FesixGermany/M3_80/documentation/pictures/soldering_jig.jpg

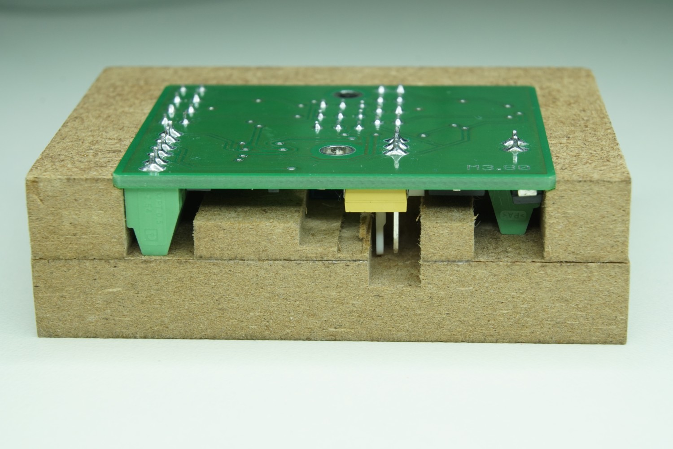
documentation/pictures/soldering_jig.jpg
