FesixGermany/M3_80/documentation/pictures/operation.jpg

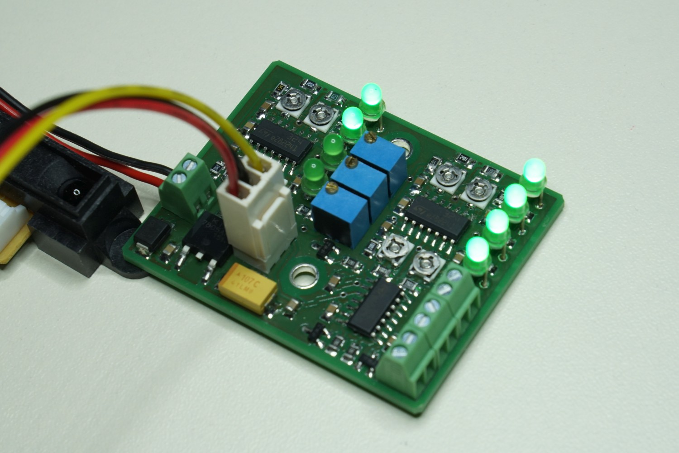
documentation/pictures/operation.jpg
