FesixGermany/M3_80/README.md

All files about the school project M3.80 we developed in a group of four in 2015.

See documentation/description_en.pdf or Beschreibung_DE.pdf for more info.
