FesixGermany/M3_80/documentation/voltage_diagrams.pdf

Tabelle1

Sensor 1 | Sensor 2
10 | 2,25 | 2,30 | 2,35
15 | 1,60 | 1,63 | 1,70
20 | 1,30 | 1,28 | 1,36
25 | 1,10 | 1,04 | 1,15
30 | 0,90 | 0,87 | 1,00
35 | 0,80 | 0,75 | 0,90
40 | 0,75 | 0,63 | 0,80
45 | 0,65 | 0,56 | 0,72
50 | 0,60 | 0,50 | 0,66
55 | 0,55 | 0,44 | 0,60
60 | 0,50 | 0,39 | 0,54
65 | 0,45 | 0,34 | 0,49
70 | 0,40 | 0,30 | 0,42

Measured voltages

Datasheet

Distance / cm | Value / V | Value / V | Value / V

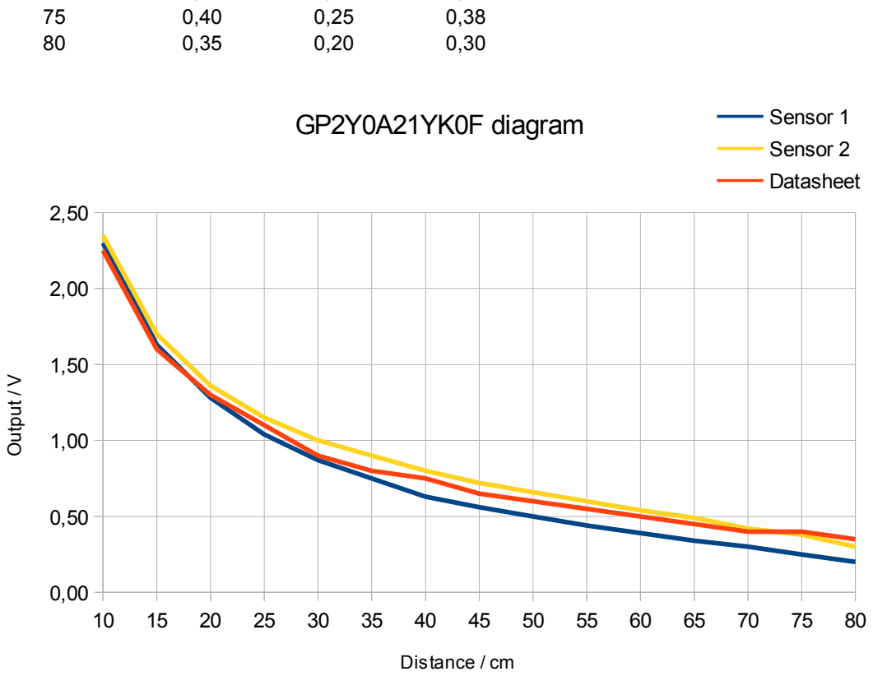
[picture p3: figure]
GP2Y0A21YK0F diagram; Sensor 1; Sensor 2 Datasheet; Distance / cm; Output / V
