FesixGermany/M3_80/documentation/pictures/cable_sensor.jpg

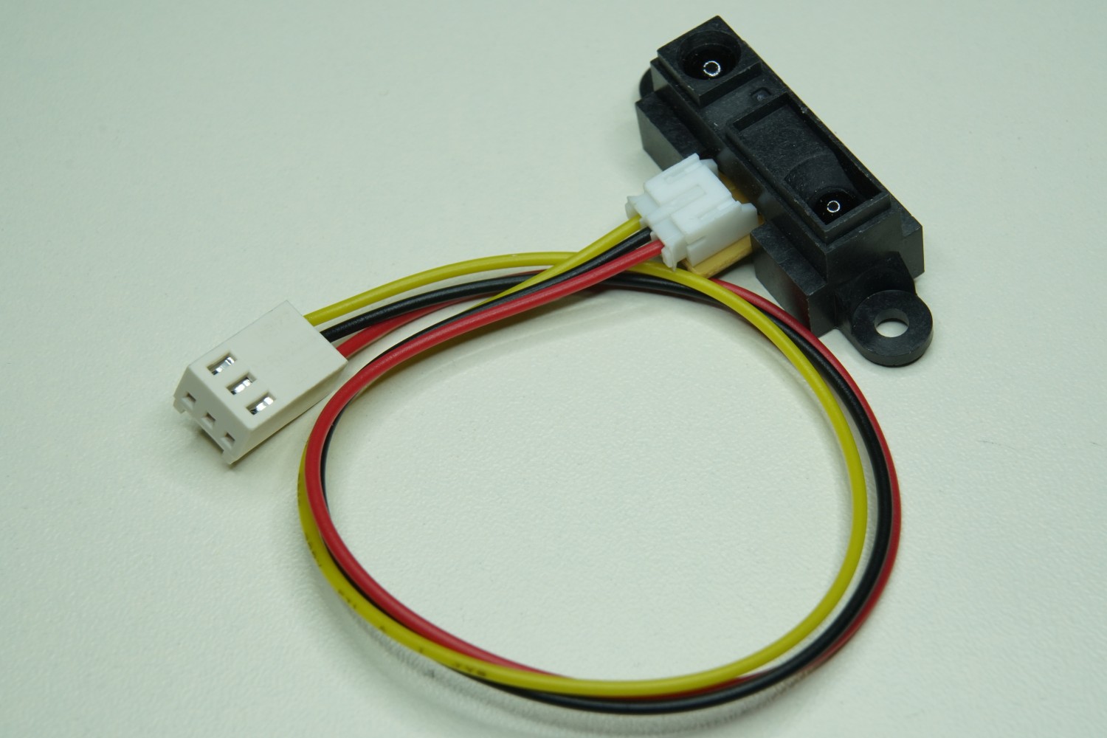
documentation/pictures/cable_sensor.jpg
