FesixGermany/M3_80/documentation/pictures/pcba.jpg

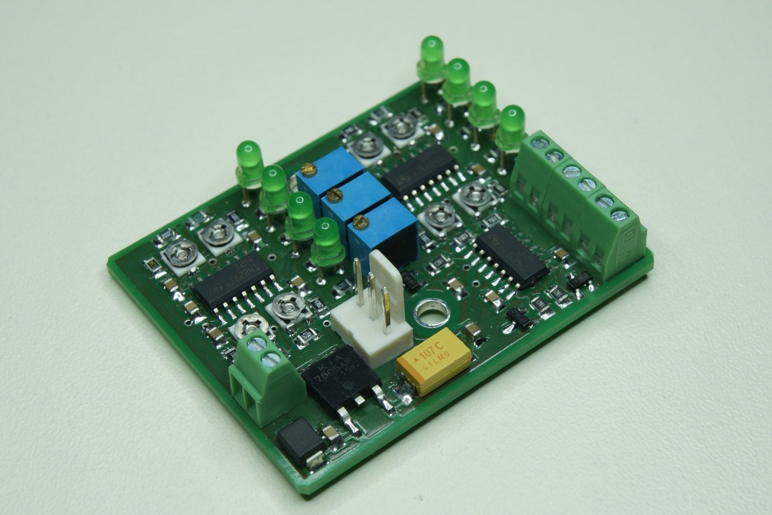
documentation/pictures/pcba.jpg
