FesixGermany/M3_80/documentation/pictures/pcba_top.jpg

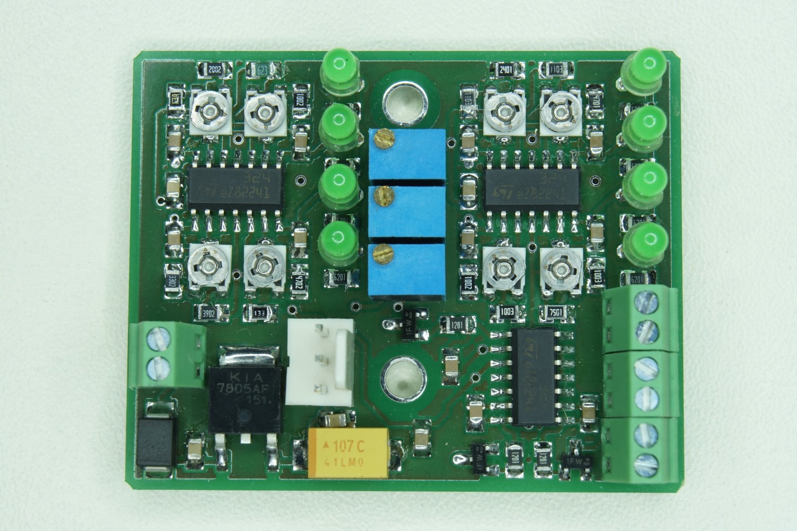
documentation/pictures/pcba_top.jpg
