FesixGermany/M3_80/documentation/pictures/prototype.jpg

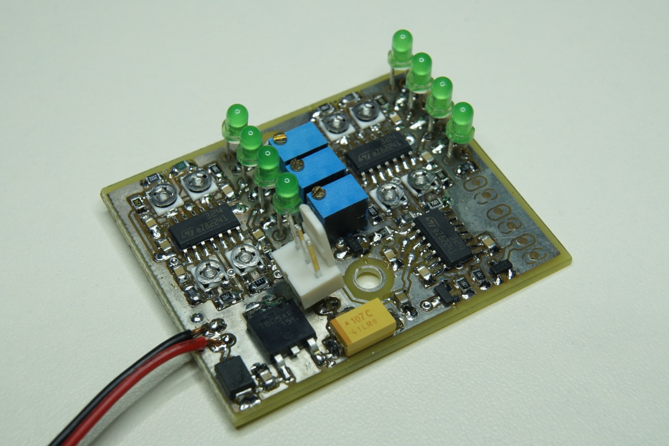
documentation/pictures/prototype.jpg
