FesixGermany/M3_80/soldering jig/soldering jig.stp

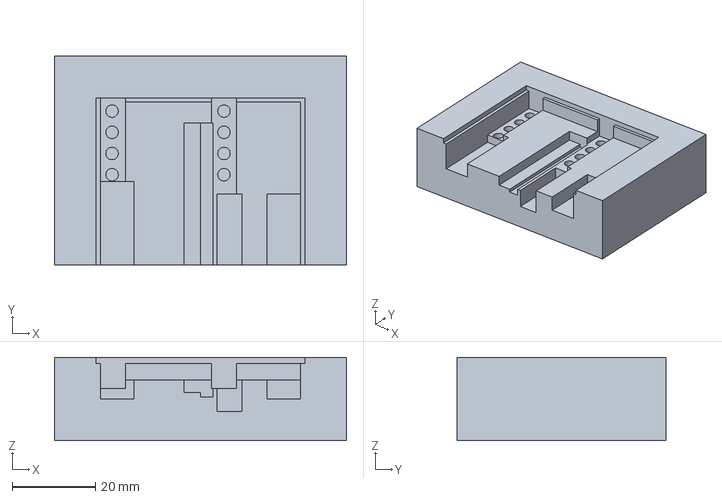
[picture p8: CAD file, 2019-12-20]
soldering jig/soldering jig.stp
70.0 x 50.0 x 20.0 mm
