FesixGermany/M3_80/documentation/M3_80_Dimensions.pdf

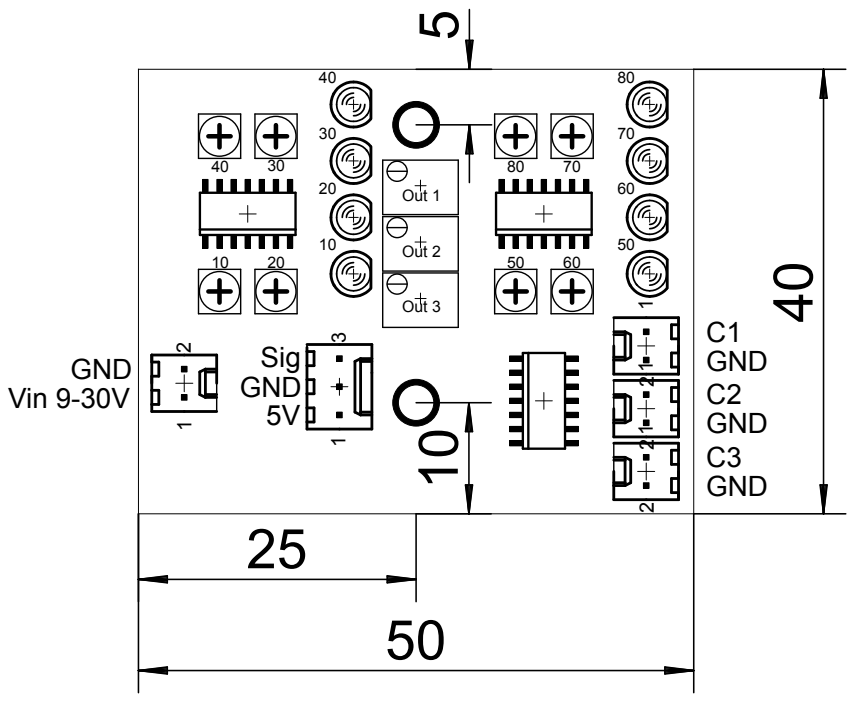
[picture p9: page 1]
C1 GND C2 GND C3 GND; GND Vin 9-30V; Sig GND 5V

Out 1

Out 2

Out 3
