FesixGermany/M3_80/documentation/M3_80_Schematic A4.pdf

A

A

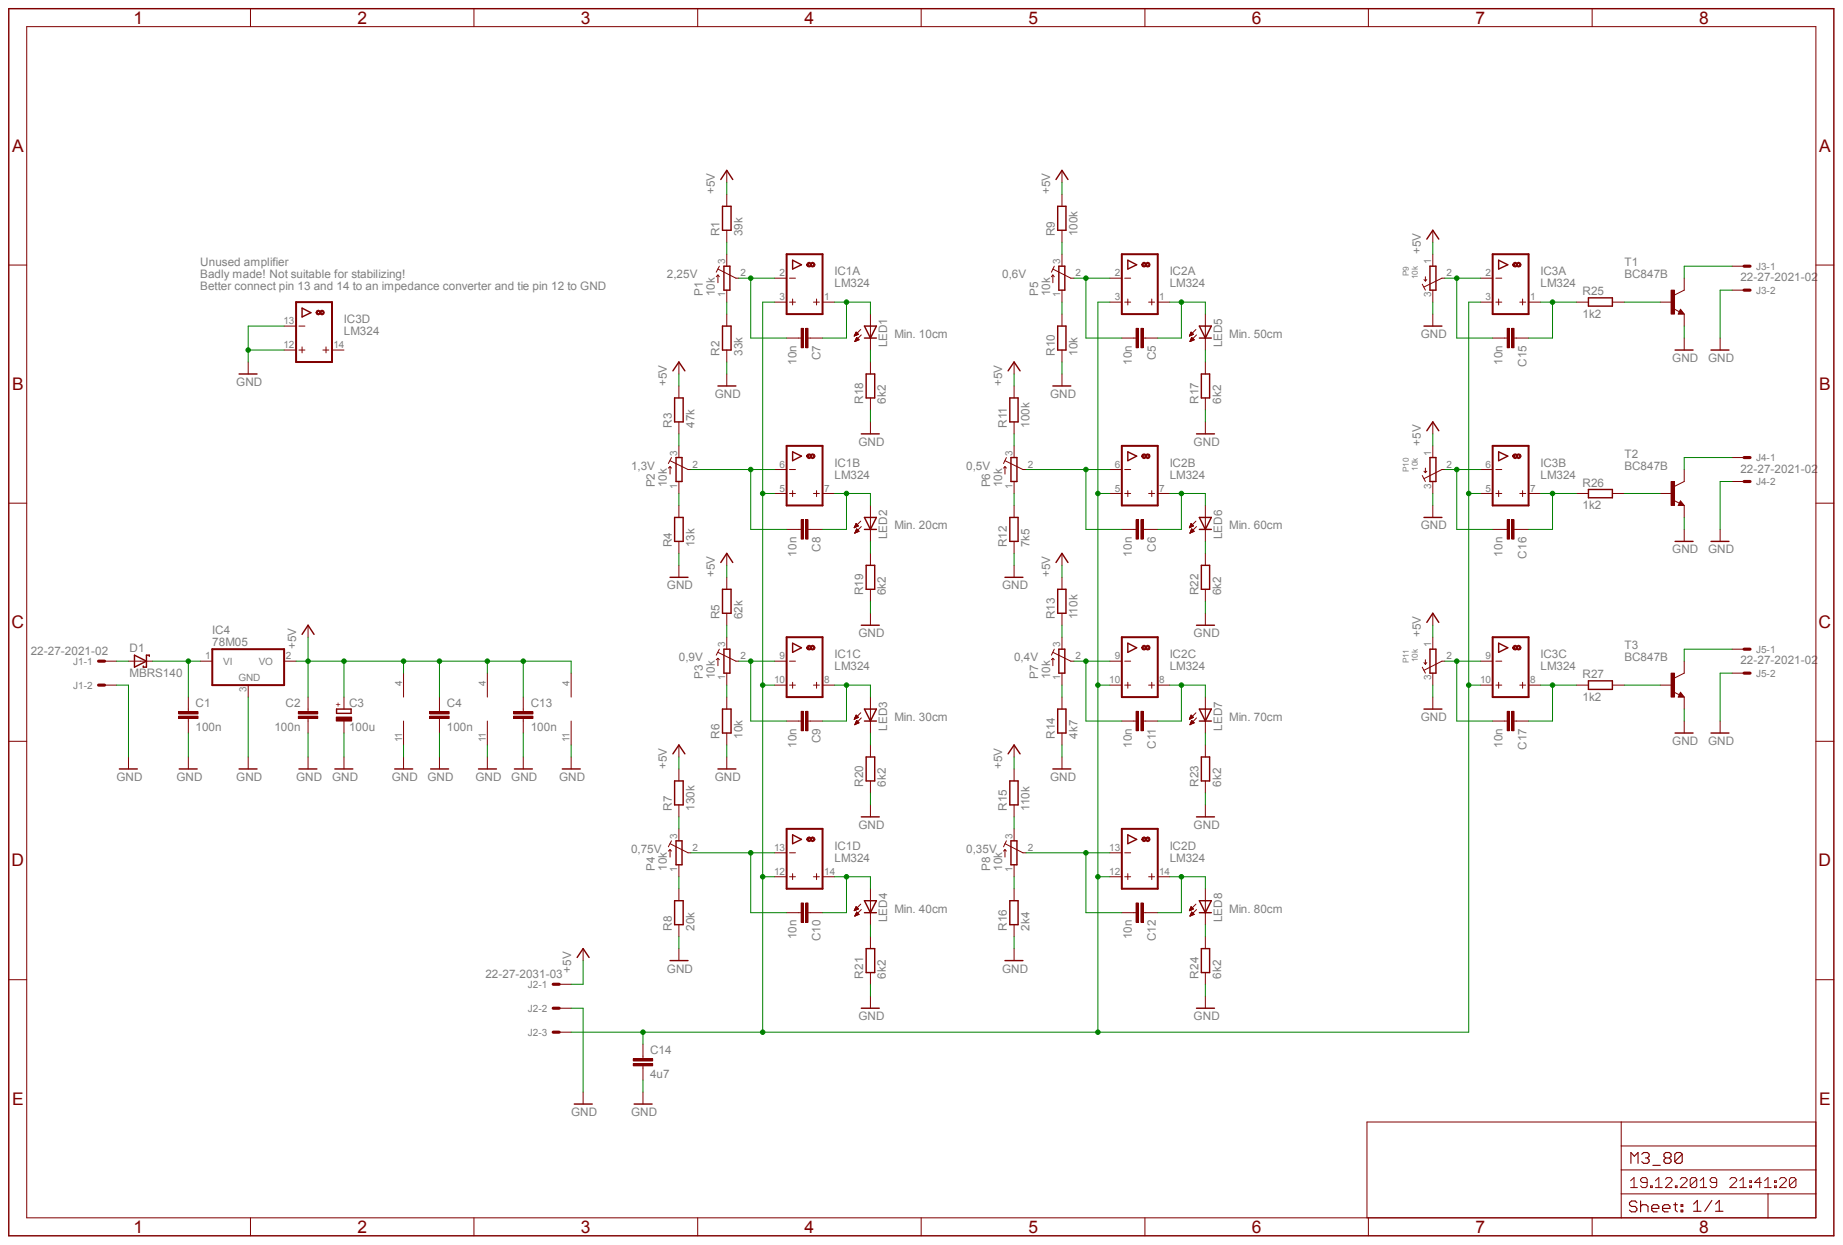
[picture p10: page 1]

Unused amplifier
Badly made! Not suitable for stabilizing!
