FesixGermany/M3_80/documentation/M3_80_Schematic_A3.pdf

A

A

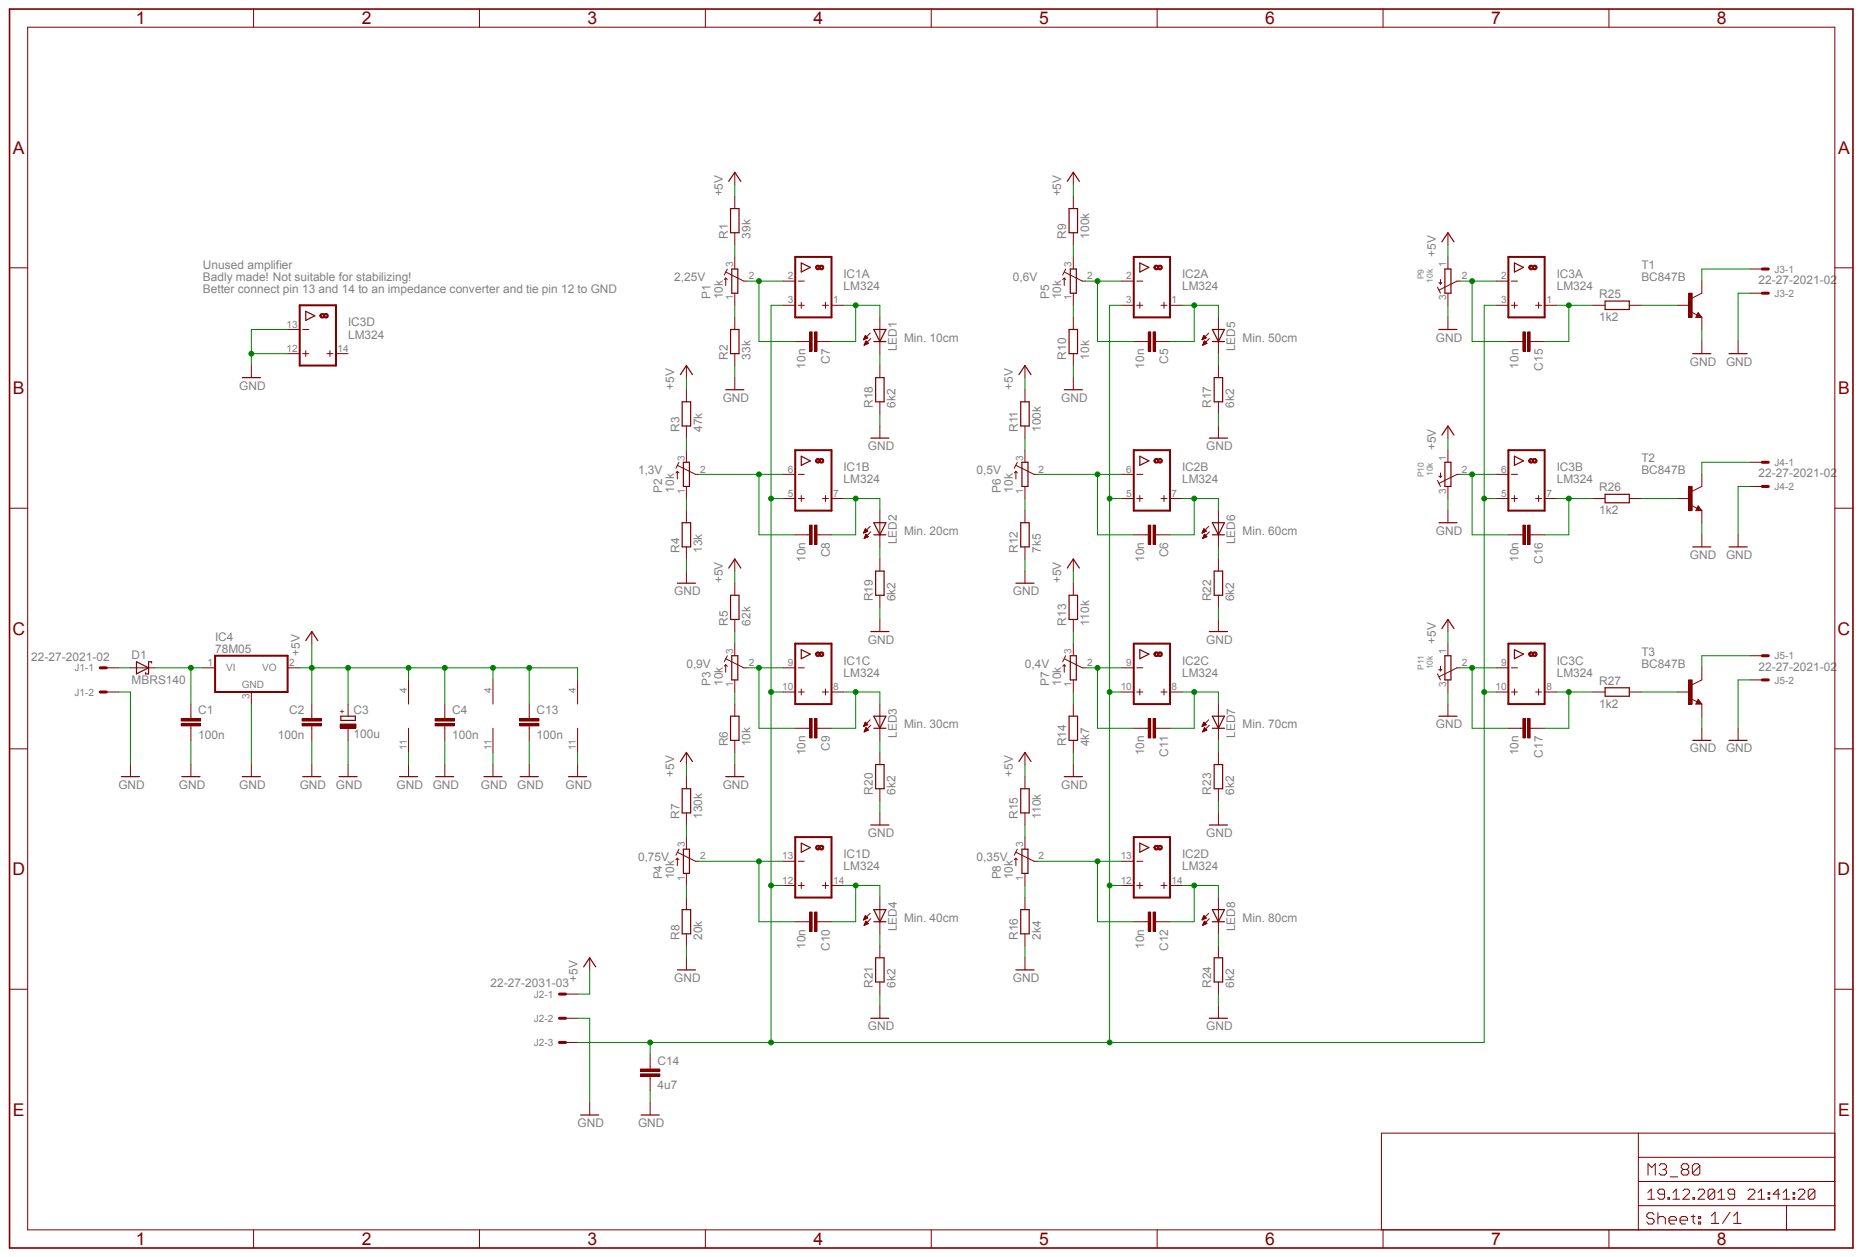
[picture p11: page 1]

Unused amplifier
Badly made! Not suitable for stabilizing!
