FesixGermany/M3_80/documentation/M3_80_Layout.pdf

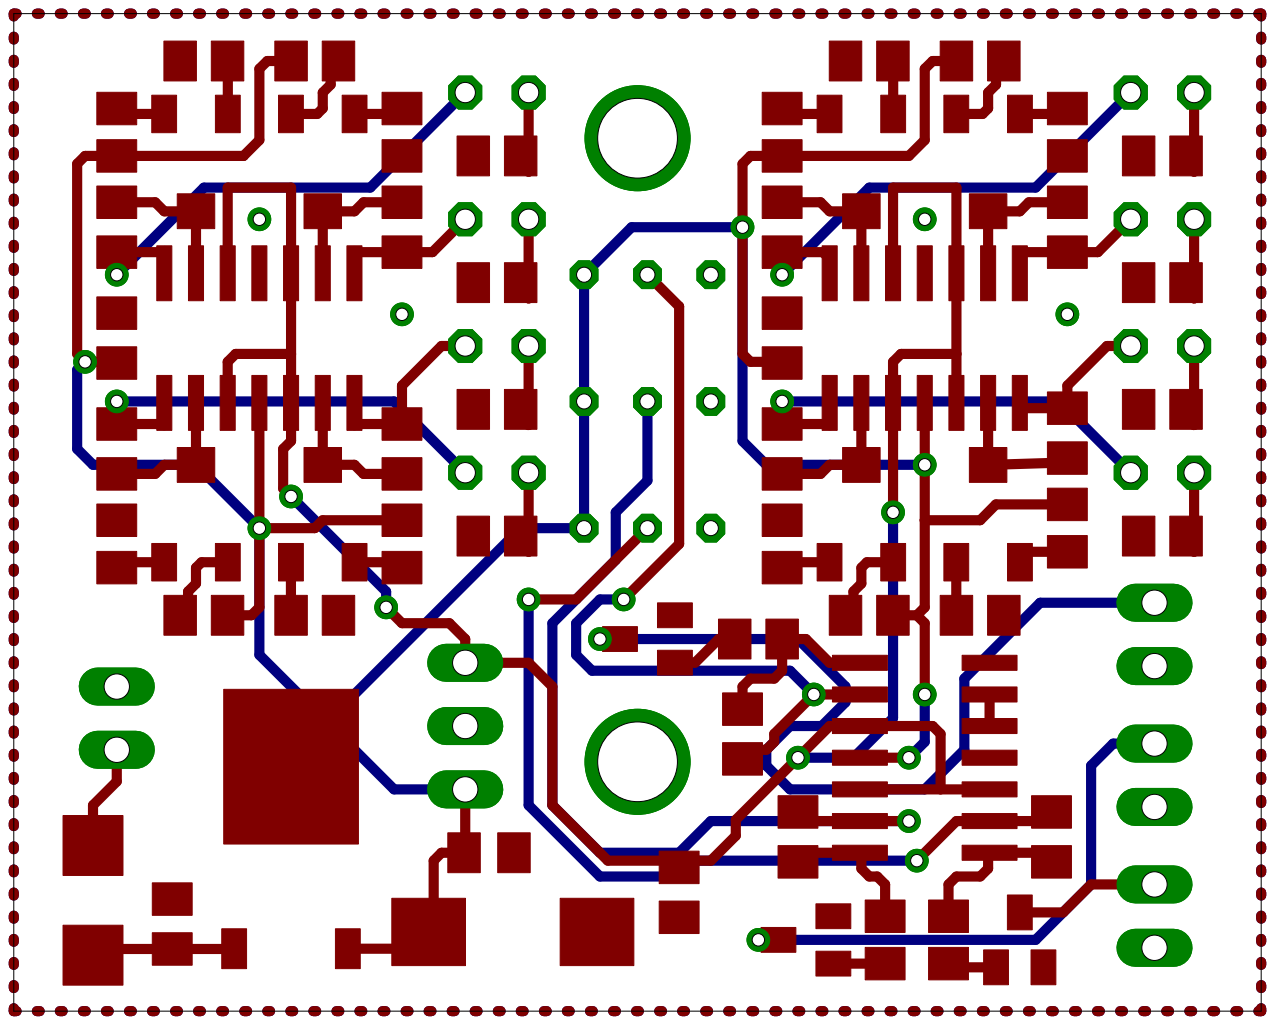
[picture p12: page 1]
