FesixGermany/M3_80/schematic and board files/M3_80.brd

## EAGLE design schematic and board files/M3_80.brd (2019-12-20)

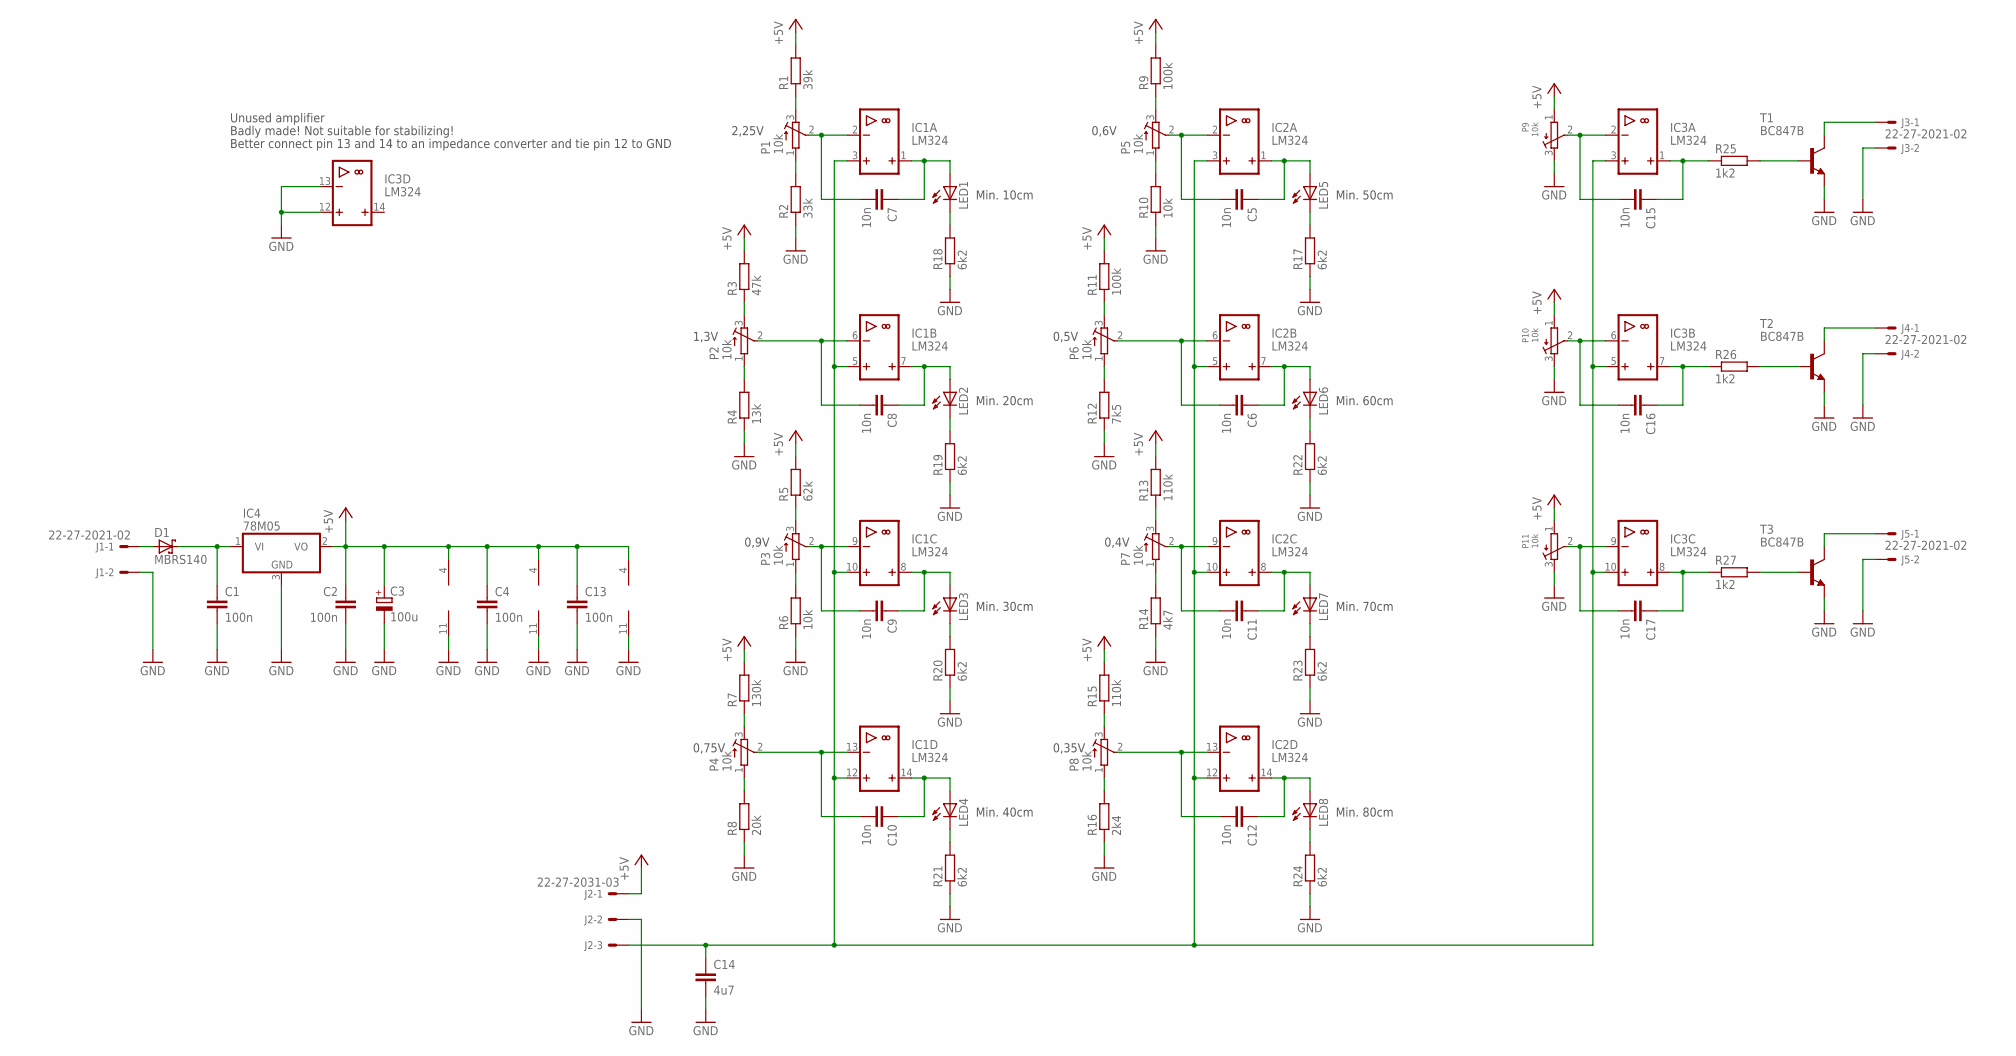
[picture p13: schematic M3_80.sch]

Parts:
C1, C2, C4, C13: 100n; C0805K
C3: 100u; D/7343-31W
C5, C6, C7, C8, C9, C10, C11, C12, C15, C16, C17: 10n; C0805K
C14: 4u7; C0805K
D1: MBRS140; SMB
IC1, IC2, IC3: LM324; SO14
IC4: 78M05; TO252
J1, J3, J4, J5: 22-27-2021-02; 6410-02
J2: 22-27-2031-03; 6410-03
LED1, LED2, LED3, LED4, LED5, LED6, LED7, LED8: LED3MM
P1, P2, P3, P4, P5, P6, P7, P8: 10k; EVM1D
P9, P10, P11: 10k; T63YA
R1: 39k; M0805
R2: 33k; M0805
R3: 47k; M0805
R4: 13k; M0805
R5: 62k; M0805
R6, R10: 10k; M0805
R7: 130k; M0805
R8: 20k; M0805
R9, R11: 100k; M0805
R12: 7k5; M0805
R13, R15: 110k; M0805
R14: 4k7; M0805
R16: 2k4; M0805
R17, R18, R19, R20, R21, R22, R23, R24: 6k2; M0805
R25, R26, R27: 1k2; M0805
T1, T2, T3: BC847B; SOT23

Connections:
+5V: C2.1, C3.+, C4.1, C13.1, IC1.4 (V+), IC2.4 (V+), IC3.4 (V+), IC4.2 (VO), J2.1, P9.1, P10.1, P11.1, R1.2, R3.2, R5.2, R7.2, R9.2, R11.2, R13.2, R15.2
GND: C1.2, C2.2, C3.-, C4.2, C13.2, C14.2, IC1.11 (V-), IC2.11 (V-), IC3.11 (V-), IC3.12 (+IN), IC3.13 (-IN), IC4.3 (GND), J1.2, J2.2, J3.2, J4.2, J5.2, P9.3, P10.3, P11.3, R2.1, R4.1, R6.1, R8.1, R10.1, R12.1, R14.1, R16.1, R17.1, R18.1, R19.1, R20.1, R21.1, R22.1, R23.1, R24.1, T1.2 (E), T2.2 (E), T3.2 (E)
unnamed: C1.1, D1.C, IC4.1 (VI)
unnamed: C7.2, IC1.2 (-IN), P1.2
unnamed: C8.2, IC1.6 (-IN), P2.2
unnamed: C9.2, IC1.9 (-IN), P3.2
unnamed: C10.2, IC1.13 (-IN), P4.2
unnamed: C5.2, IC2.2 (-IN), P5.2
unnamed: C6.2, IC2.6 (-IN), P6.2
unnamed: C11.2, IC2.9 (-IN), P7.2
unnamed: C12.2, IC2.13 (-IN), P8.2
unnamed: C5.1, IC2.1 (OUT), LED5.A
unnamed: LED5.K (C), R17.2
unnamed: C8.1, IC1.7 (OUT), LED2.A
unnamed: LED2.K (C), R19.2
unnamed: C7.1, IC1.1 (OUT), LED1.A
unnamed: LED1.K (C), R18.2
unnamed: C9.1, IC1.8 (OUT), LED3.A
unnamed: LED3.K (C), R20.2
unnamed: C10.1, IC1.14 (OUT), LED4.A
unnamed: LED4.K (C), R21.2
unnamed: C6.1, IC2.7 (OUT), LED6.A
unnamed: LED6.K (C), R22.2
unnamed: C11.1, IC2.8 (OUT), LED7.A
unnamed: LED7.K (C), R23.2
unnamed: C12.1, IC2.14 (OUT), LED8.A
unnamed: LED8.K (C), R24.2
unnamed: P5.3, R9.1
unnamed: P5.1, R10.2
unnamed: P6.3, R11.1
unnamed: P6.1, R12.2
unnamed: P7.3, R13.1
unnamed: P7.1, R14.2
unnamed: P8.3, R15.1
unnamed: P1.3, R1.1
unnamed: P8.1, R16.2
unnamed: C16.2, IC3.6 (-IN), P10.2
unnamed: C15.2, IC3.2 (-IN), P9.2
unnamed: C17.2, IC3.9 (-IN), P11.2
unnamed: P1.1, R2.2
unnamed: D1.A, J1.1
unnamed: P2.3, R3.1
unnamed: P2.1, R4.2
unnamed: P3.3, R5.1
unnamed: P3.1, R6.2
unnamed: P4.3, R7.1
unnamed: P4.1, R8.2
unnamed: C15.1, IC3.1 (OUT), R25.1
unnamed: R25.2, T1.1 (B)
unnamed: C16.1, IC3.7 (OUT), R26.1
unnamed: R26.2, T2.1 (B)
unnamed: C17.1, IC3.8 (OUT), R27.1
unnamed: R27.2, T3.1 (B)
unnamed: J5.1, T3.3 (C)
unnamed: J4.1, T2.3 (C)
unnamed: J3.1, T1.3 (C)
unnamed: C14.1, IC1.3 (+IN), IC1.5 (+IN), IC1.10 (+IN), IC1.12 (+IN), IC2.3 (+IN), IC2.5 (+IN), IC2.10 (+IN), IC2.12 (+IN), IC3.3 (+IN), IC3.5 (+IN), IC3.10 (+IN), J2.3

Notes on the sheet:
Min. 10cm
Min. 20cm
Min. 30cm
Min. 40cm
2,25V
1,3V
0,9V
0,75V
Min. 50cm
Min. 60cm
Min. 70cm
Min. 80cm
0,6V
0,5V
0,4V
0,35V
Unused amplifier
Badly made! Not suitable for stabilizing!
Better connect pin 13 and 14 to an impedance converter and tie pin 12 to GND

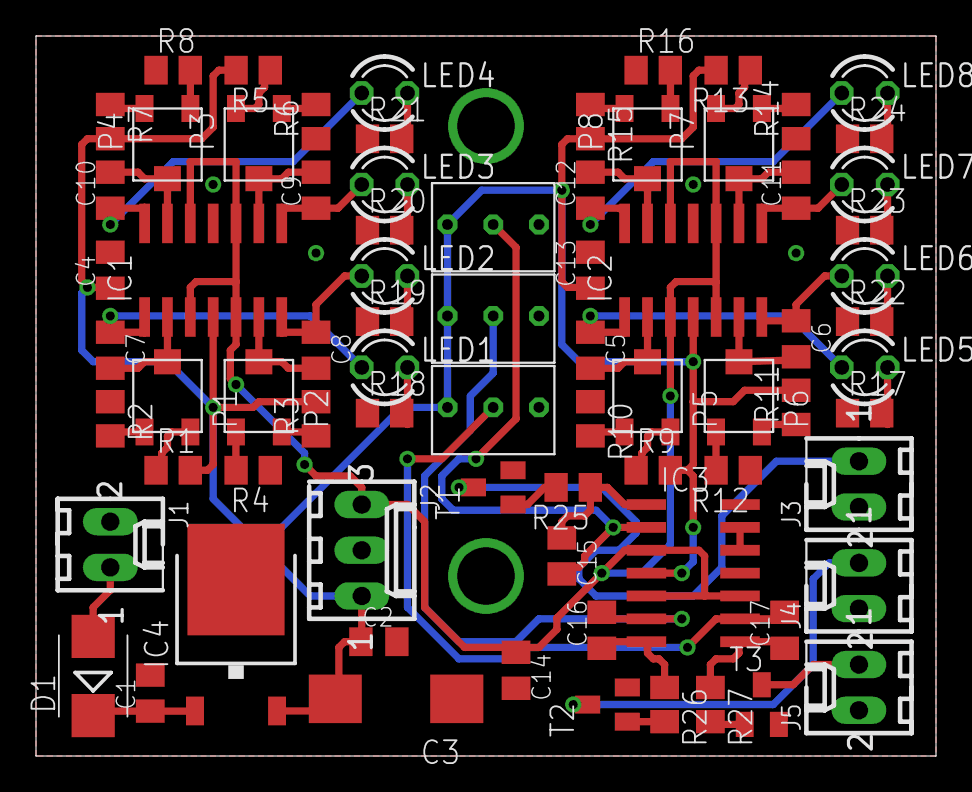
[picture p14: board M3_80.brd from above]

Board: 2 copper layers, 50.0 x 40.0 mm, 76 parts (0 on the bottom side), 57 nets.
